ae-hesham/Compact-ATmega328PB-Castellated-Microcontroller-Module/hardware/CORE-328PB_RevA_Schematic_PCB_BOM.pdf

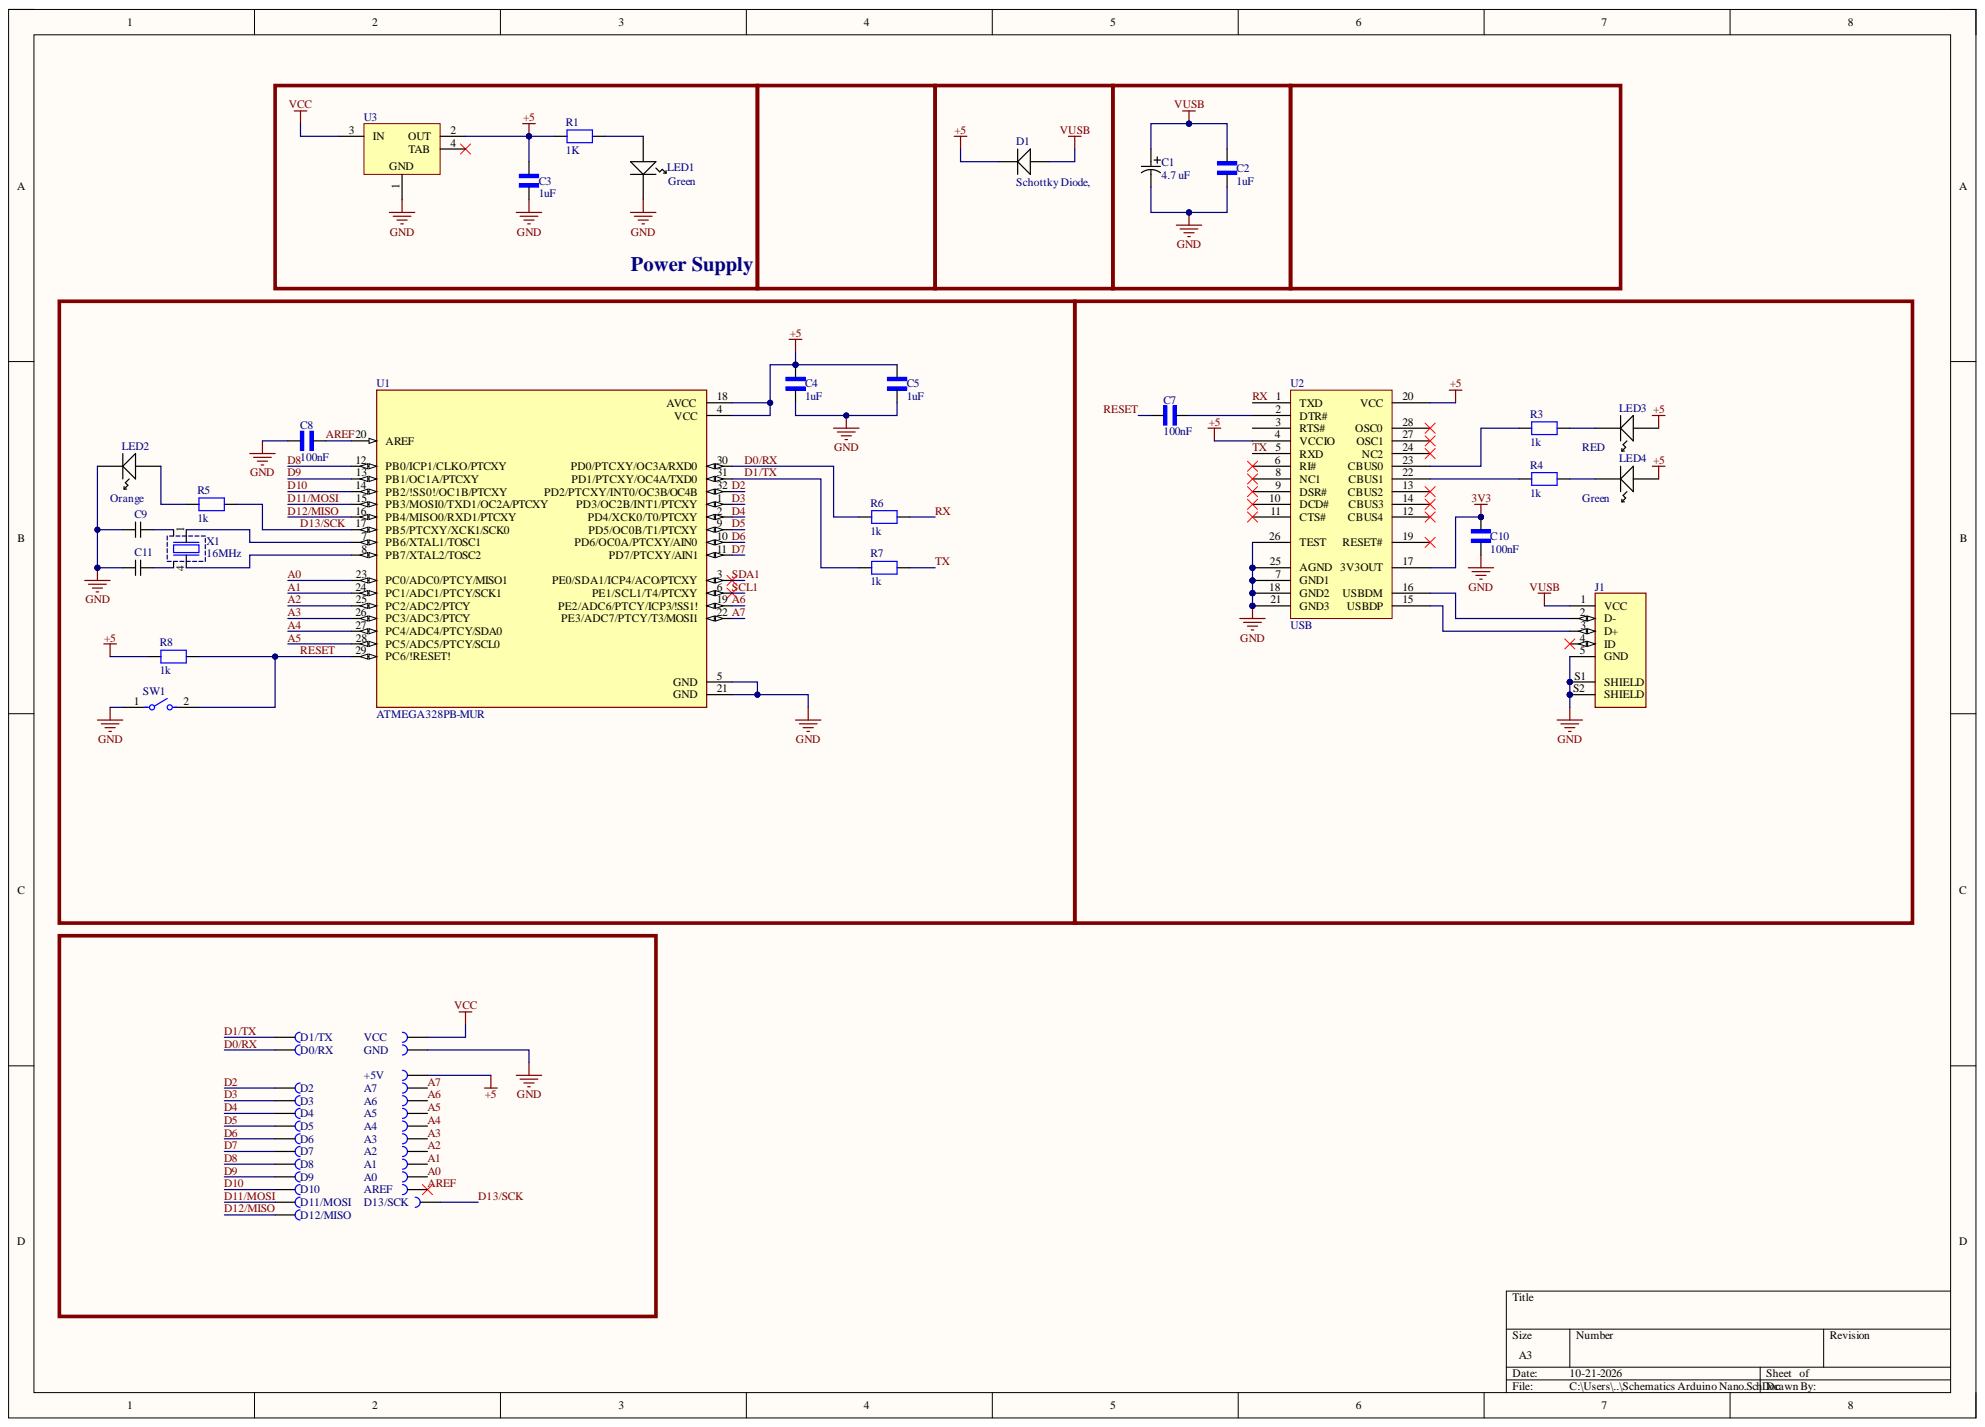
[picture p6: page 1]

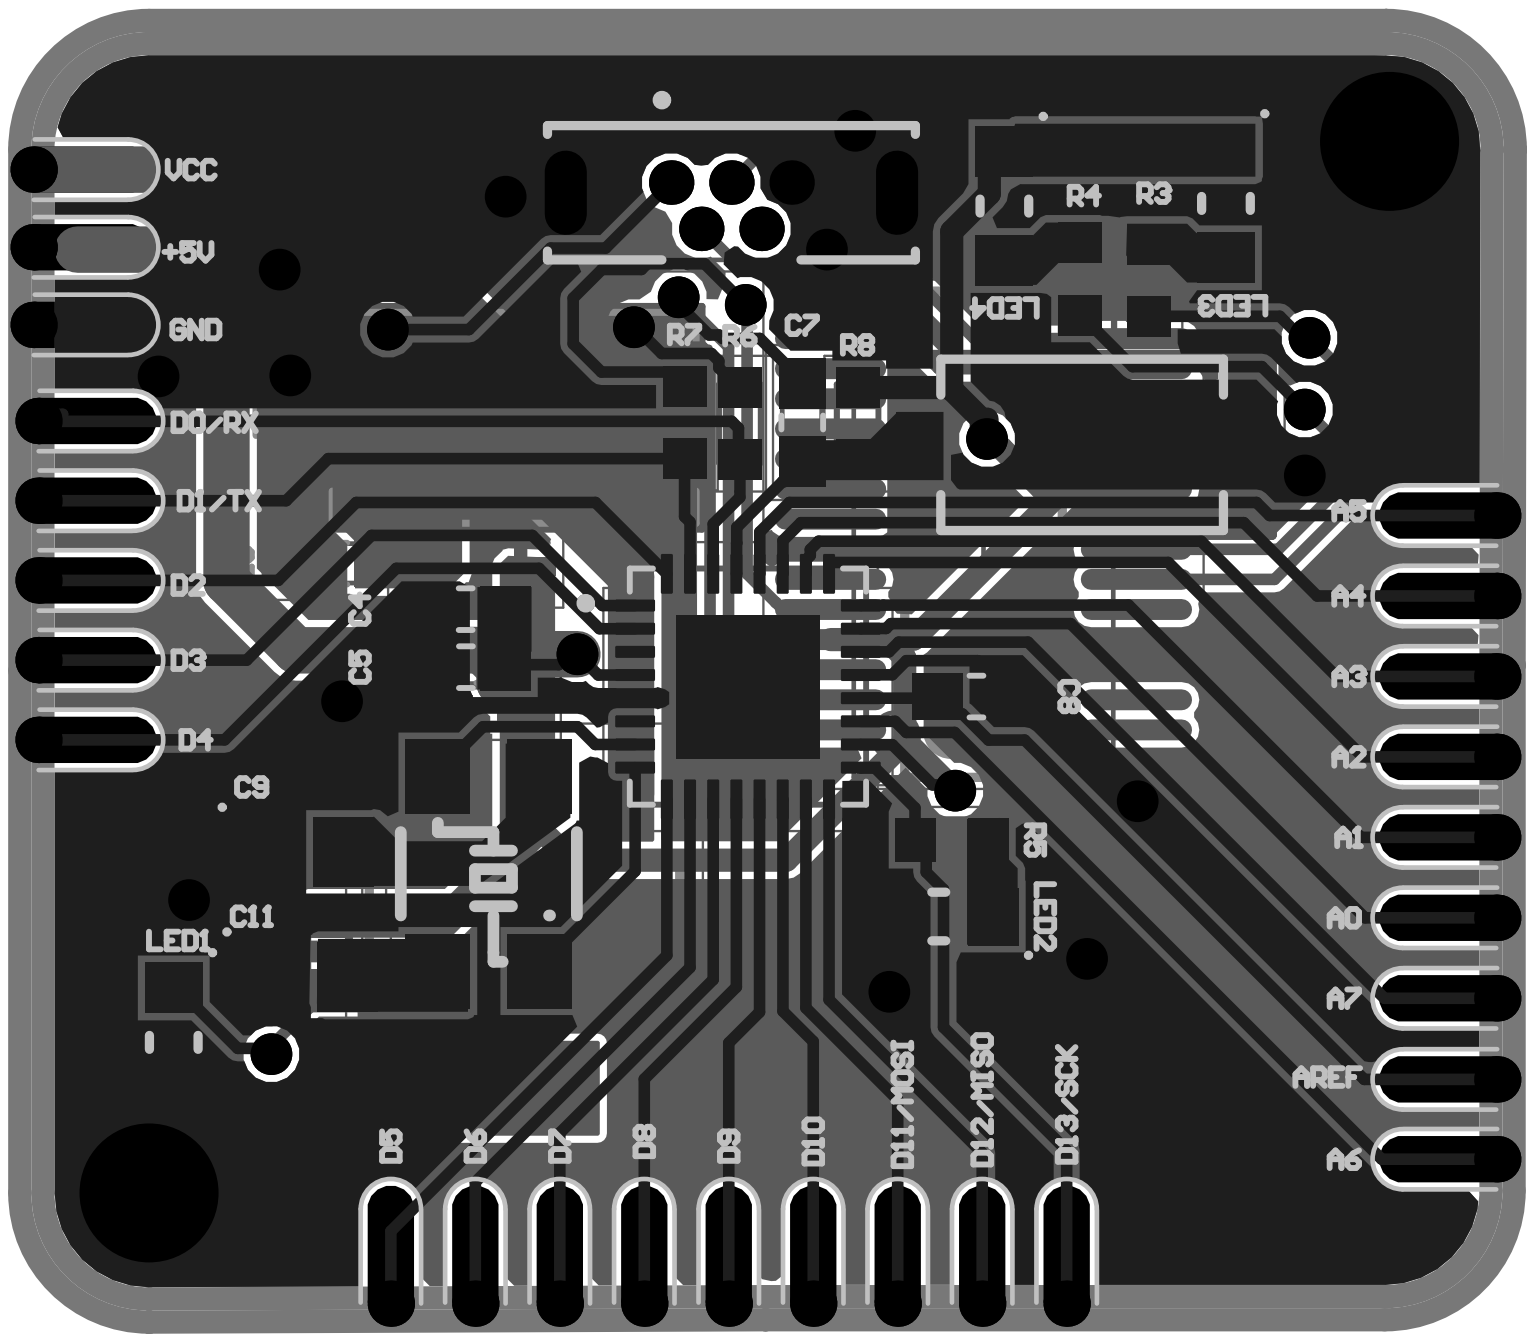
[picture p7: page 2]

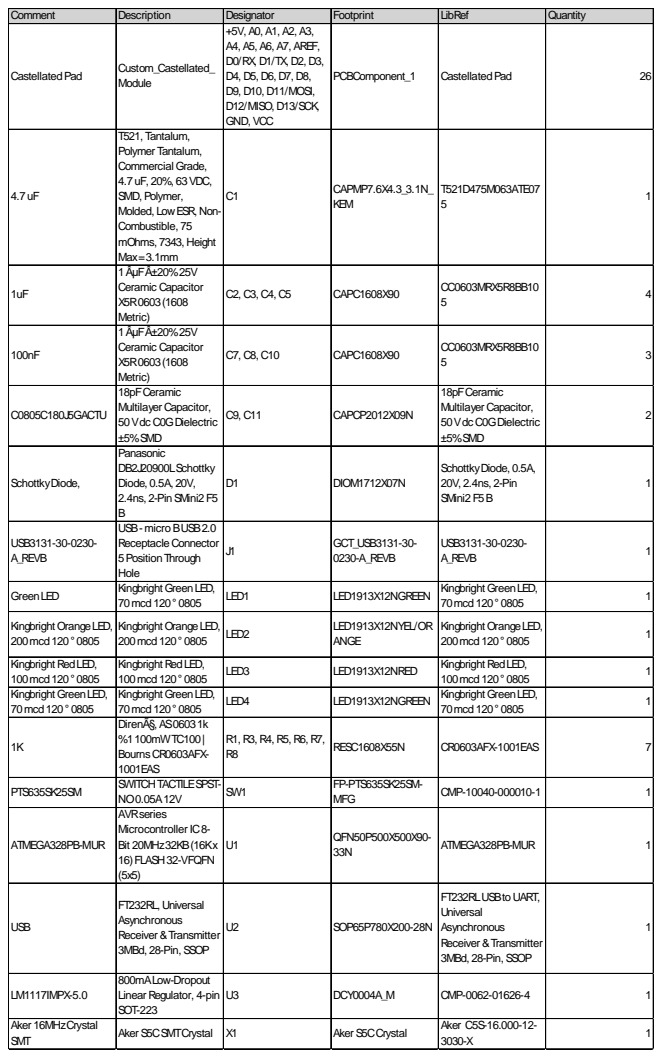
[picture p8: page 3]

Comment | Description | Designator | Footprint | LibRef | Quantity
CastellatedPad | Custom_Castellated_ Module | +5V, A0, A1, A2, A3, A4, A5, A6, A7, AREF, D0/RX, D1/TX, D2, D3, D4, D5, D6, D7, D8, D9, D10, D11/MOSI, D12/MISO, D13/SCK, GND, VCC | PCBComponent_1 | CastellatedPad | 26

4.7uF | T521, Tantalum, Polymer Tantalum, Commercial Grade, 4.7uF, 20%, 63VDC, SMD, Polymer, Molded, LowESR, Non-Combustible, 75 mOhms, 7343, Height Max=3.1mm | C1 | CAPMP7.6X4.3_3.1N_ KEM | T521D475M063ATE07 5 | 1

1uF | 1ÂµFÂ±20%25V Ceramic Capacitor X5R0603(1608 Metric) | C2, C3, C4, C5 | CAPC1608X90 | CC0603MRX5R8BB10 5 | 4

100nF | 1ÂµFÂ±20%25V Ceramic Capacitor X5R0603(1608 Metric) | C7, C8, C10 | CAPC1608X90 | CC0603MRX5R8BB10 5 | 3

C0805C180J5GACTU | 18pFCeramic Multilayer Capacitor, 50Vdc C0GDielectric ±5%SMD | C9, C11 | CAPCP2012X09N | 18pFCeramic Multilayer Capacitor, 50Vdc C0GDielectric ±5%SMD | 2

SchottkyDiode, | Panasonic DB2J20900LSchottky Diode, 0.5A, 20V, 2.4ns, 2-PinSMini2F5 B | D1 | DIOM1712X07N | SchottkyDiode, 0.5A, 20V, 2.4ns, 2-Pin SMini2F5B | 1

USB3131-30-0230-A_REVB | USB- microBUSB2.0 Receptacle Connector 5PositionThrough Hole | J1 | GCT_USB3131-30-0230-A_REVB | USB3131-30-0230-A_REVB | 1

GreenLED | Kingbright GreenLED, 70mcd120° 0805 | LED1 | LED1913X12NGREEN | Kingbright GreenLED, 70mcd120° 0805 | 1

Kingbright OrangeLED, 200mcd120° 0805 | Kingbright OrangeLED, 200mcd120° 0805 | LED2 | LED1913X12NYEL/OR ANGE | Kingbright OrangeLED, 200mcd120° 0805 | 1

Kingbright RedLED, 100mcd120° 0805 | Kingbright RedLED, 100mcd120° 0805 | LED3 | LED1913X12NRED | Kingbright RedLED, 100mcd120° 0805 | 1

Kingbright GreenLED, 70mcd120° 0805 | Kingbright GreenLED, 70mcd120° 0805 | LED4 | LED1913X12NGREEN | Kingbright GreenLED, 70mcd120° 0805 | 1

1K | DirenÃ§, AS06031k %1100mWTC100| BournsCR0603AFX-1001EAS | R1, R3, R4, R5, R6, R7, R8 | RESC1608X55N | CR0603AFX-1001EAS | 7

PTS635SK25SM | SWITCHTACTILESPST-NO0.05A12V | SW1 | FP-PTS635SK25SM-MFG | CMP-10040-000010-1 | 1

ATMEGA328PB-MUR | AVRseries Microcontroller IC8-Bit 20MHz32KB(16Kx 16)FLASH32-VFQFN (5x5) | U1 | QFN50P500X500X90-33N | ATMEGA328PB-MUR | 1

USB | FT232RL, Universal Asynchronous Receiver &Transmitter 3MBd, 28-Pin, SSOP | U2 | SOP65P780X200-28N | FT232RLUSBtoUART, Universal Asynchronous Receiver &Transmitter 3MBd, 28-Pin, SSOP | 1

LM1117IMPX-5.0 | 800mALow-Dropout Linear Regulator, 4-pin SOT-223 | U3 | DCY0004A_M | CMP-0062-01626-4 | 1

Aker 16MHzCrystal SMT | Aker S5CSMTCrystal | X1 | Aker S5CCrystal | Aker C5S-16.000-12-3030-X | 1
