ae-hesham/Compact-ATmega328PB-Castellated-Microcontroller-Module/(list of files, drawings)

Other design files:
hardware/CORE-328PB.PcbDoc
hardware/CORE-328PB.SchDoc
