ae-hesham/Compact-ATmega328PB-Castellated-Microcontroller-Module/(commit log)

2026-10-22 Rename pcb_3d_angled.png to pcb_3d_ang led.png
2026-10-22 Rename pcb_3d_ang led.png to pcb_3d_angled.png
