ae-hesham/Compact-ATmega328PB-Castellated-Microcontroller-Module/(notices)

Notices in the files:
README.md:
License: Proprietary
